aryanb1032/autonomous-sorting-robot-arm/hardware/stl/README.md

# Arm STL files

Source: the project owner's `arm stl` folder. The STL files are copied without geometry changes. Keep the original filenames so exported part names remain recognizable.

| File | Size |
|---|---:|
| `Arm 01.1.STL` | 205,784 bytes |
| `Arm 02.1.STL` | 133,684 bytes |
| `Base of Robotic Arm.STL` | 149,384 bytes |
| `Gripper cam.stl` | 302,584 bytes |
| `Rack.stl` | 168,884 bytes |
| `base J1.STL` | 282,584 bytes |
| `bearing.STL` | 57,284 bytes |
| `bearingball.STL` | 292,684 bytes |
| `g frame 1.STL` | 87,584 bytes |
| `gripper connector.STL` | 247,884 bytes |
| `gripper finger.stl` | 93,484 bytes |
| `link 3.2.STL` | 105,084 bytes |

STL files do not reliably carry print units. Confirm scale in the slicer/CAD software before printing.
