aryanb1032/autonomous-sorting-robot-arm/hardware/stl/Gripper cam.stl

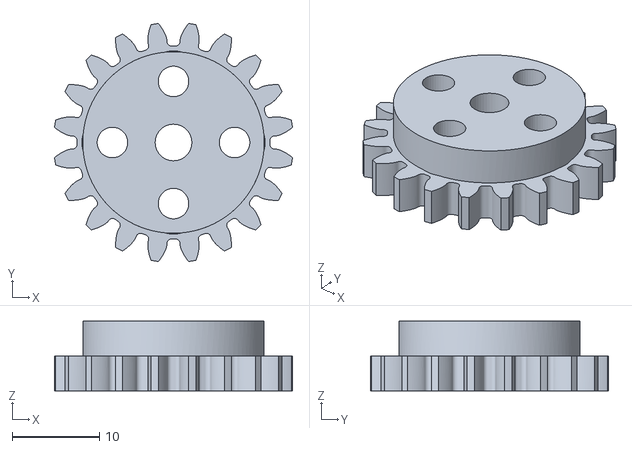
[picture p1: CAD file, 2026-11-10]
hardware/stl/Gripper cam.stl
27.3 x 27.3 x 8.00
