aryanb1032/autonomous-sorting-robot-arm/hardware/stl/bearingball.STL

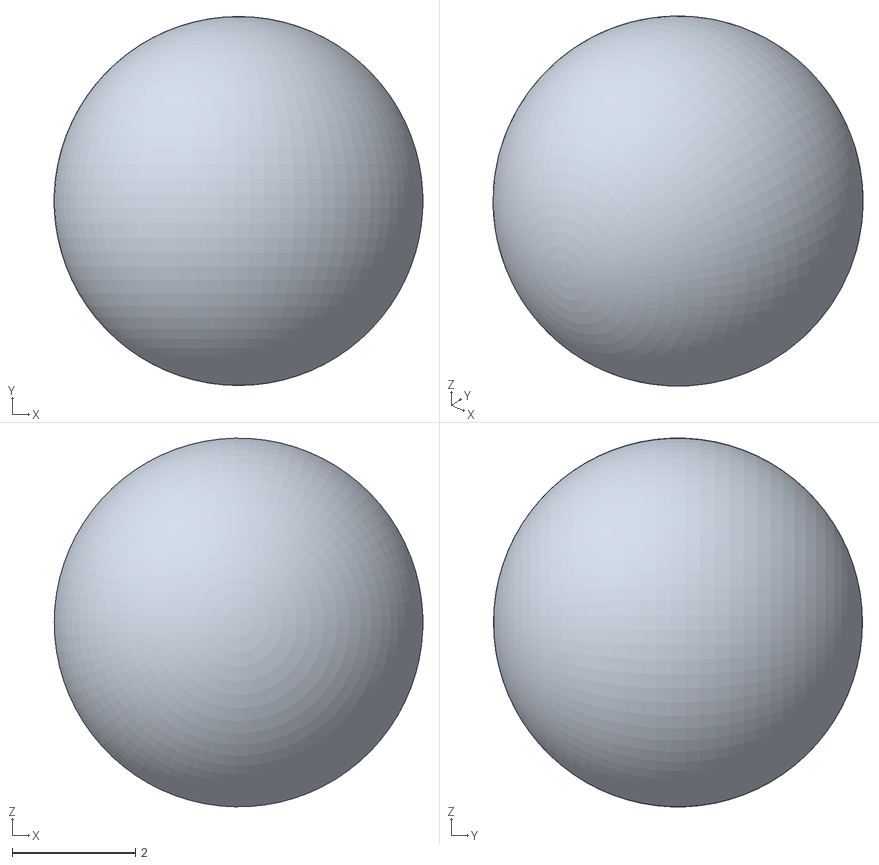
[picture p2: CAD file, 2026-11-10]
hardware/stl/bearingball.STL
5.99 x 6.00 x 5.99
