aryanb1032/autonomous-sorting-robot-arm/hardware/stl/g frame 1.STL

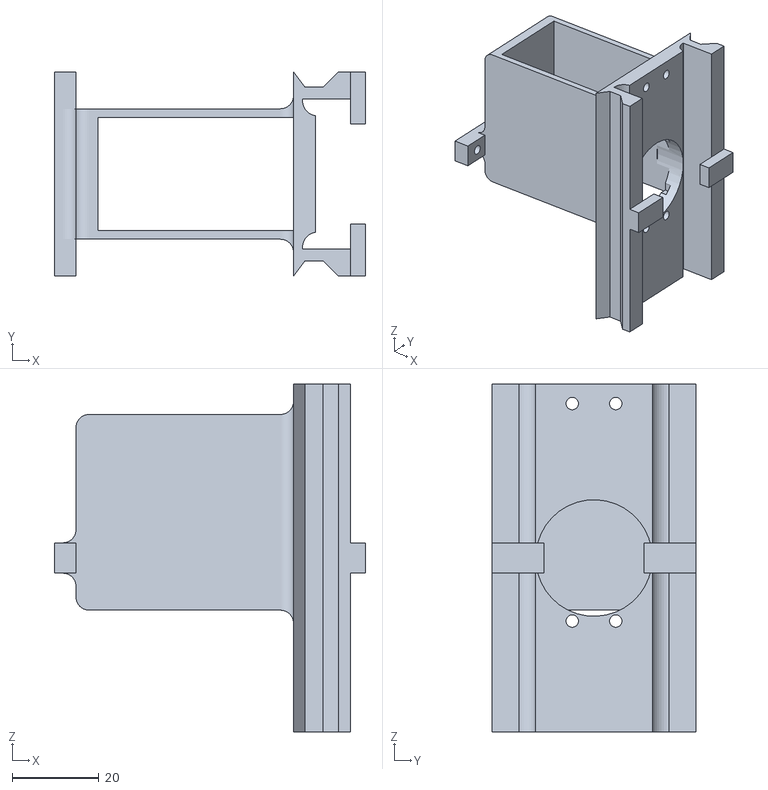
[picture p3: CAD file, 2026-11-10]
hardware/stl/g frame 1.STL
71.6 x 47.0 x 80.0
