aryanb1032/autonomous-sorting-robot-arm/hardware/stl/link 3.2.STL

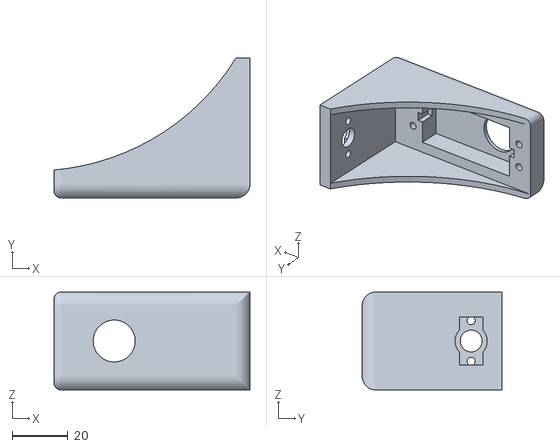
[picture p4: CAD file, 2026-11-10]
hardware/stl/link 3.2.STL
70.0 x 50.0 x 35.0
