aryanb1032/autonomous-sorting-robot-arm/hardware/stl/gripper finger.stl

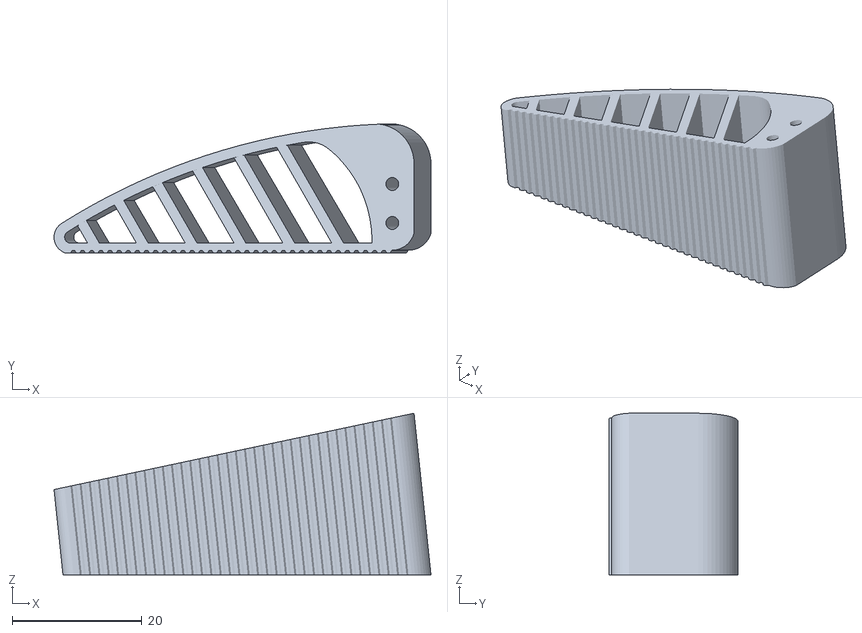
[picture p5: CAD file, 2026-11-10]
hardware/stl/gripper finger.stl
58.0 x 19.8 x 24.9
