aryanb1032/autonomous-sorting-robot-arm/hardware/stl/Rack.stl

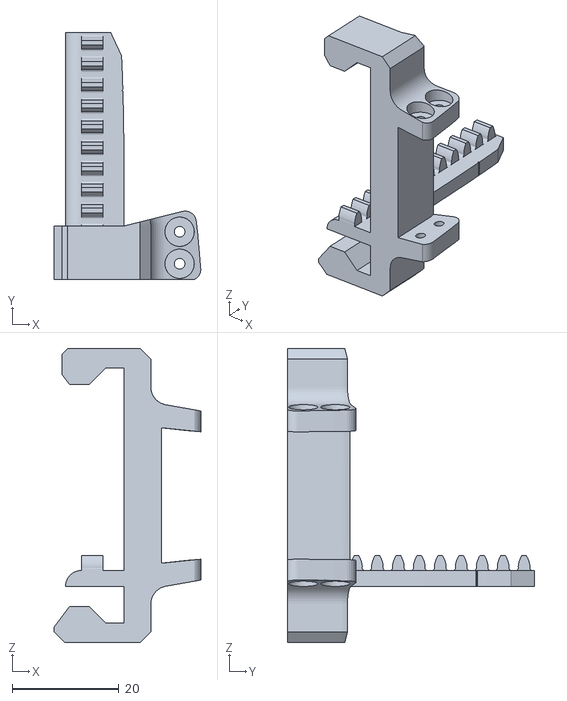
[picture p6: CAD file, 2026-11-10]
hardware/stl/Rack.stl
27.5 x 46.2 x 55.1
