aryanb1032/autonomous-sorting-robot-arm/hardware/stl/Base of Robotic Arm.STL

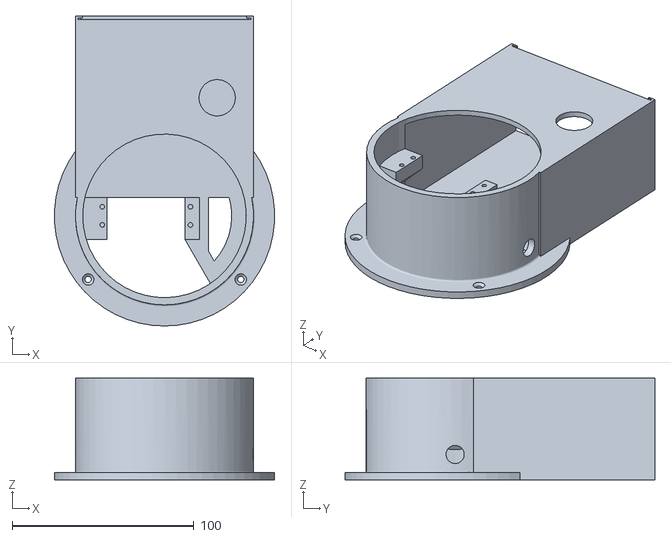
[picture p7: CAD file, 2026-11-10]
hardware/stl/Base of Robotic Arm.STL
121.1 x 170.6 x 56.0
