aryanb1032/autonomous-sorting-robot-arm/hardware/stl/Arm 01.1.STL

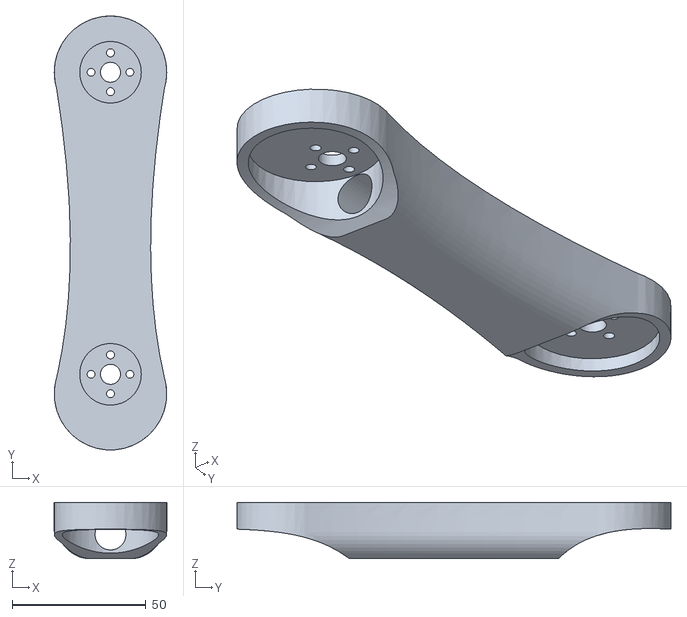
[picture p8: CAD file, 2026-11-10]
hardware/stl/Arm 01.1.STL
42.0 x 162.0 x 21.0
