aryanb1032/autonomous-sorting-robot-arm/hardware/stl/gripper connector.STL

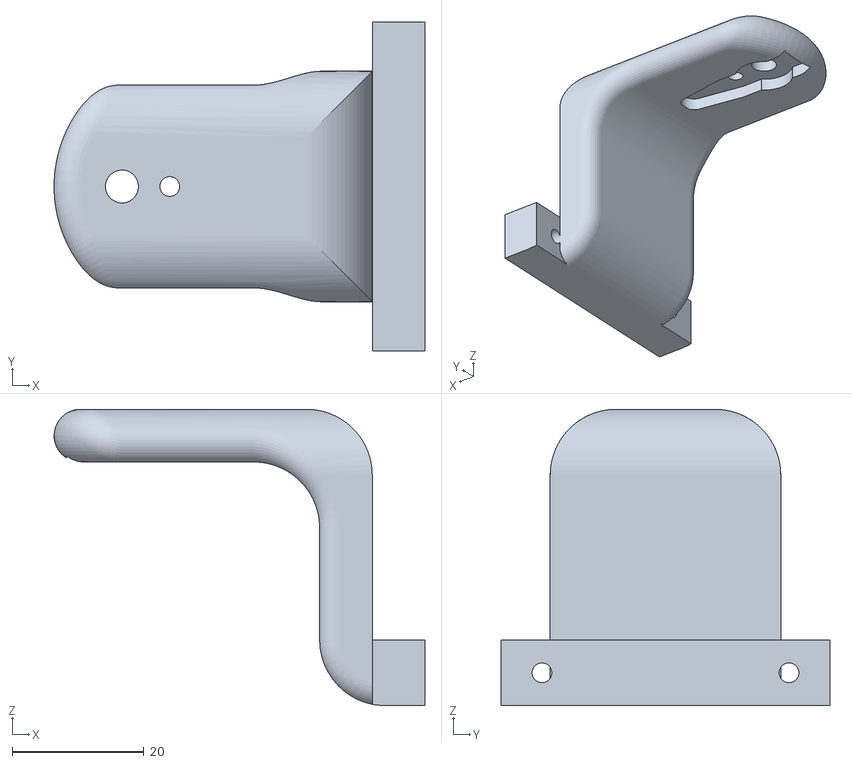
[picture p9: CAD file, 2026-11-10]
hardware/stl/gripper connector.STL
56.3 x 50.0 x 45.0
