aryanb1032/autonomous-sorting-robot-arm/hardware/stl/base J1.STL

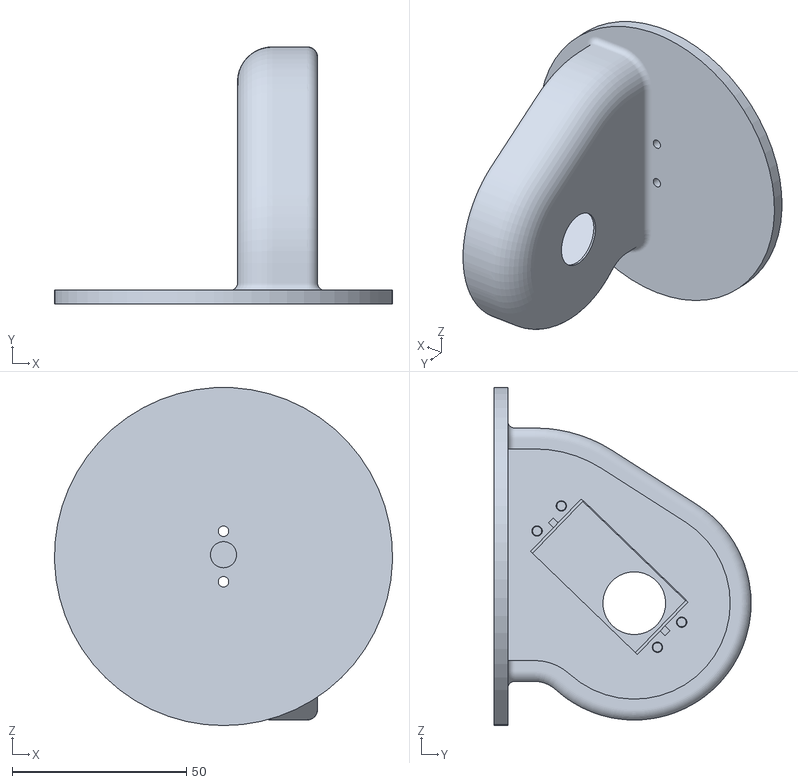
[picture p10: CAD file, 2026-11-10]
hardware/stl/base J1.STL
97.0 x 73.8 x 97.0
