aryanb1032/autonomous-sorting-robot-arm/hardware/stl/Arm 02.1.STL

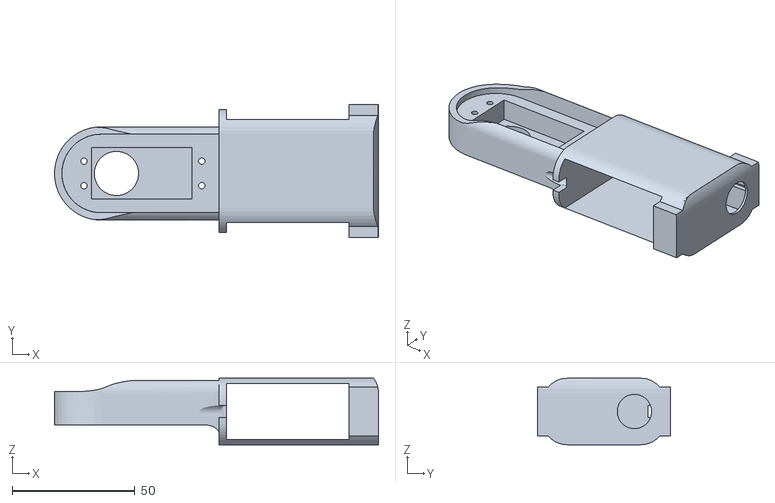
[picture p11: CAD file, 2026-11-10]
hardware/stl/Arm 02.1.STL
132.0 x 54.0 x 27.1
