aryanb1032/autonomous-sorting-robot-arm/hardware/stl/bearing.STL

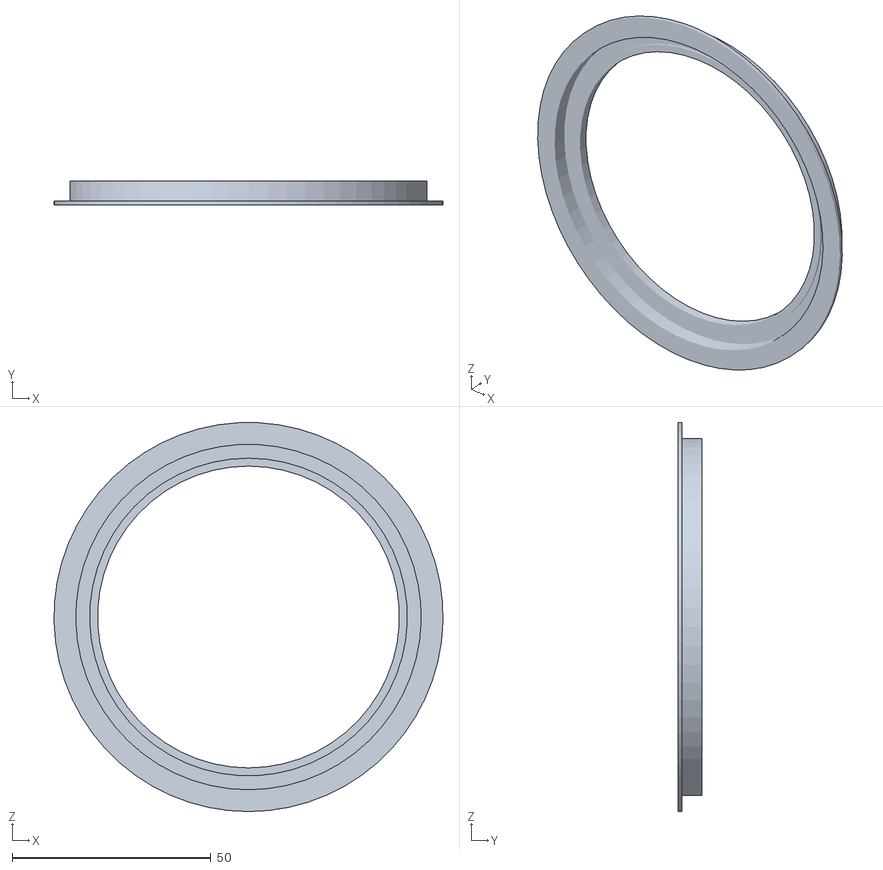
[picture p12: CAD file, 2026-11-10]
hardware/stl/bearing.STL
98.0 x 6.00 x 98.0
