aryanb1032/autonomous-sorting-robot-arm/ros2_ws/src/arm_simulation/urdf/provisional_arm.urdf

<?xml version="1.0" ?>
<!-- =================================================================================== -->
<!-- |    This document was autogenerated by xacro from ros2_ws/src/arm_simulation/urdf/provisional_arm.urdf.xacro | -->
<!-- |    EDITING THIS FILE BY HAND IS NOT RECOMMENDED                                 | -->
<!-- =================================================================================== -->
<!-- Final user axis distances, 2026-10-29. Collision/visual shapes and masses are
approximations. The pictured linkage is represented by two mirrored hinged jaws;
its exact four-bar dimensions and servo linkage remain unmeasured. -->
<robot name="provisional_arm">
  <link name="world"/>
  <link name="base_link">
    <inertial>
      <origin xyz="0 0 0.0175"/>
      <mass value="1.0"/>
      <inertia ixx="0.0013020833333333333" ixy="0" ixz="0" iyy="0.0013020833333333333" iyz="0" izz="0.0024"/>
    </inertial>
    <visual>
      <origin xyz="0 0 0.0175"/>
      <geometry>
        <box size="0.12 0.12 0.035"/>
      </geometry>
      <material name="base_link_colour">
        <color rgba=".12 .14 .18 1"/>
      </material>
    </visual>
    <collision>
      <origin xyz="0 0 0.0175"/>
      <geometry>
        <box size="0.12 0.12 0.035"/>
      </geometry>
    </collision>
  </link>
  <joint name="world_fixed" type="fixed">
    <parent link="world"/>
    <child link="base_link"/>
    <origin xyz="0 0 0"/>
  </joint>
  <link name="base_rotor">
    <inertial>
      <origin xyz="0 0 0.0095"/>
      <mass value="0.2"/>
      <inertia ixx="6.601666666666667e-05" ixy="0" ixz="0" iyy="6.601666666666667e-05" iyz="0" izz="0.00012"/>
    </inertial>
    <visual>
      <origin xyz="0 0 0.0095"/>
      <geometry>
        <box size="0.06 0.06 0.019"/>
      </geometry>
      <material name="base_rotor_colour">
        <color rgba=".15 .4 .75 1"/>
      </material>
    </visual>
    <collision>
      <origin xyz="0 0 0.0095"/>
      <geometry>
        <box size="0.06 0.06 0.019"/>
      </geometry>
    </collision>
  </link>
  <joint name="sim_joint_1" type="revolute">
    <parent link="base_link"/>
    <child link="base_rotor"/>
    <origin xyz="0 0 0.035"/>
    <axis xyz="0 0 1"/>
    <limit effort="20" lower="-2.8" upper="2.8" velocity="0.6"/>
    <dynamics damping="0.1" friction="0.01"/>
  </joint>
  <link name="upper_arm">
    <inertial>
      <origin xyz="0 0 0.06"/>
      <mass value="0.3"/>
      <inertia ixx="0.00039062499999999997" ixy="0" ixz="0" iyy="0.00039062499999999997" iyz="0" izz="6.125000000000001e-05"/>
    </inertial>
    <visual>
      <origin xyz="0 0 0.06"/>
      <geometry>
        <box size="0.035 0.035 0.12"/>
      </geometry>
      <material name="upper_arm_colour">
        <color rgba=".15 .4 .75 1"/>
      </material>
    </visual>
    <collision>
      <origin xyz="0 0 0.06"/>
      <geometry>
        <box size="0.035 0.035 0.12"/>
      </geometry>
    </collision>
  </link>
  <joint name="sim_joint_2" type="revolute">
    <parent link="base_rotor"/>
    <child link="upper_arm"/>
    <origin xyz="0 0 0.019"/>
    <axis xyz="0 1 0"/>
    <limit effort="20" lower="-1.4" upper="1.4" velocity="0.6"/>
    <dynamics damping="0.1" friction="0.01"/>
  </joint>
  <link name="forearm">
    <inertial>
      <origin xyz="0 0 0.055"/>
      <mass value="0.25"/>
      <inertia ixx="0.0002708333333333333" ixy="0" ixz="0" iyy="0.0002708333333333333" iyz="0" izz="3.75e-05"/>
    </inertial>
    <visual>
      <origin xyz="0 0 0.055"/>
      <geometry>
        <box size="0.03 0.03 0.11"/>
      </geometry>
      <material name="forearm_colour">
        <color rgba=".15 .4 .75 1"/>
      </material>
    </visual>
    <collision>
      <origin xyz="0 0 0.055"/>
      <geometry>
        <box size="0.03 0.03 0.11"/>
      </geometry>
    </collision>
  </link>
  <joint name="sim_joint_3" type="revolute">
    <parent link="upper_arm"/>
    <child link="forearm"/>
    <origin xyz="0 0 0.12"/>
    <axis xyz="0 1 0"/>
    <limit effort="20" lower="-2.0" upper="2.0" velocity="0.6"/>
    <dynamics damping="0.1" friction="0.01"/>
  </joint>
  <link name="wrist_pitch">
    <inertial>
      <origin xyz="0 0 0.03"/>
      <mass value="0.08"/>
      <inertia ixx="3.4666666666666665e-05" ixy="0" ixz="0" iyy="3.4666666666666665e-05" iyz="0" izz="2.1333333333333338e-05"/>
    </inertial>
    <visual>
      <origin xyz="0 0 0.03"/>
      <geometry>
        <box size="0.04 0.04 0.06"/>
      </geometry>
      <material name="wrist_pitch_colour">
        <color rgba=".15 .4 .75 1"/>
      </material>
    </visual>
    <collision>
      <origin xyz="0 0 0.03"/>
      <geometry>
        <box size="0.04 0.04 0.06"/>
      </geometry>
    </collision>
  </link>
  <joint name="sim_joint_4" type="revolute">
    <parent link="forearm"/>
    <child link="wrist_pitch"/>
    <origin xyz="0 0 0.11"/>
    <axis xyz="0 1 0"/>
    <limit effort="20" lower="-1.5" upper="1.5" velocity="0.6"/>
    <dynamics damping="0.1" friction="0.01"/>
  </joint>
  <link name="gripper_palm">
    <inertial>
      <origin xyz="0 0 0.05"/>
      <mass value="0.1"/>
      <inertia ixx="0.00010020833333333335" ixy="0" ixz="0" iyy="9.666666666666668e-05" iyz="0" izz="3.020833333333333e-05"/>
    </inertial>
    <visual>
      <origin xyz="0 0 0.05"/>
      <geometry>
        <box size="0.04 0.045 0.1"/>
      </geometry>
      <material name="gripper_palm_colour">
        <color rgba=".15 .4 .75 1"/>
      </material>
    </visual>
    <collision>
      <origin xyz="0 0 0.05"/>
      <geometry>
        <box size="0.04 0.045 0.1"/>
      </geometry>
    </collision>
  </link>
  <joint name="sim_joint_5" type="revolute">
    <parent link="wrist_pitch"/>
    <child link="gripper_palm"/>
    <origin xyz="0 0 0.06"/>
    <axis xyz="0 0 1"/>
    <limit effort="20" lower="-2.8" upper="2.8" velocity="0.6"/>
    <dynamics damping="0.1" friction="0.01"/>
  </joint>
  <link name="left_finger">
    <inertial>
      <origin xyz="0 0 0.035"/>
      <mass value="0.025"/>
      <inertia ixx="1.0341666666666668e-05" ixy="0" ixz="0" iyy="1.0508333333333336e-05" iyz="0" izz="4.333333333333334e-07"/>
    </inertial>
    <visual>
      <origin xyz="0 0 0.035"/>
      <geometry>
        <box size="0.012 0.008 0.07"/>
      </geometry>
      <material name="left_finger_colour">
        <color rgba=".9 .9 .85 1"/>
      </material>
    </visual>
    <collision>
      <origin xyz="0 0 0.035"/>
      <geometry>
        <box size="0.012 0.008 0.07"/>
      </geometry>
    </collision>
  </link>
  <joint name="sim_finger_joint" type="revolute">
    <parent link="gripper_palm"/>
    <child link="left_finger"/>
    <origin xyz="0 .012 0.1"/>
    <axis xyz="-1 0 0"/>
    <limit effort="20" lower="0.0" upper="0.4" velocity="0.6"/>
    <dynamics damping="0.1" friction="0.01"/>
  </joint>
  <link name="right_finger">
    <inertial>
      <origin xyz="0 0 0.035"/>
      <mass value="0.025"/>
      <inertia ixx="1.0341666666666668e-05" ixy="0" ixz="0" iyy="1.0508333333333336e-05" iyz="0" izz="4.333333333333334e-07"/>
    </inertial>
    <visual>
      <origin xyz="0 0 0.035"/>
      <geometry>
        <box size="0.012 0.008 0.07"/>
      </geometry>
      <material name="right_finger_colour">
        <color rgba=".9 .9 .85 1"/>
      </material>
    </visual>
    <collision>
      <origin xyz="0 0 0.035"/>
      <geometry>
        <box size="0.012 0.008 0.07"/>
      </geometry>
    </collision>
  </link>
  <joint name="sim_finger_mimic" type="revolute">
    <parent link="gripper_palm"/>
    <child link="right_finger"/>
    <origin xyz="0 -.012 0.1"/>
    <axis xyz="1 0 0"/>
    <limit effort="20" lower="0.0" upper="0.4" velocity="0.6"/>
    <dynamics damping="0.1" friction="0.01"/>
    <mimic joint="sim_finger_joint" multiplier="1" offset="0"/>
  </joint>
  <link name="gripper_motor_frame"/>
  <joint name="gripper_motor_fixed" type="fixed">
    <parent link="gripper_palm"/>
    <child link="gripper_motor_frame"/>
    <origin xyz="0 0 0.1"/>
  </joint>
  <link name="tool0"/>
  <joint name="tool_fixed" type="fixed">
    <parent link="gripper_palm"/>
    <child link="tool0"/>
    <origin xyz="0 0 0.17"/>
  </joint>
  <link name="camera_link">
    <inertial>
      <origin xyz="0.035 0 0"/>
      <mass value="0.015"/>
      <inertia ixx="1.0625e-06" ixy="0" ixz="0" iyy="1.0625e-06" iyz="0" izz="1.5625e-06"/>
    </inertial>
    <visual>
      <origin xyz="0.035 0 0"/>
      <geometry>
        <box size="0.025 0.025 0.015"/>
      </geometry>
      <material name="camera_link_colour">
        <color rgba=".1 .1 .1 1"/>
      </material>
    </visual>
    <collision>
      <origin xyz="0.035 0 0"/>
      <geometry>
        <box size="0.025 0.025 0.015"/>
      </geometry>
    </collision>
  </link>
  <joint name="camera_fixed" type="fixed">
    <parent link="gripper_palm"/>
    <child link="camera_link"/>
    <origin xyz="0 0 0.1"/>
  </joint>
  <ros2_control name="SimulationOnly" type="system">
    <hardware>
      <plugin>mock_components/GenericSystem</plugin>
    </hardware>
    <joint name="sim_joint_1">
      <command_interface name="position"/>
      <state_interface name="position">
        <param name="initial_value">0</param>
      </state_interface>
      <state_interface name="velocity"/>
    </joint>
    <joint name="sim_joint_2">
      <command_interface name="position"/>
      <state_interface name="position">
        <param name="initial_value">0</param>
      </state_interface>
      <state_interface name="velocity"/>
    </joint>
    <joint name="sim_joint_3">
      <command_interface name="position"/>
      <state_interface name="position">
        <param name="initial_value">0</param>
      </state_interface>
      <state_interface name="velocity"/>
    </joint>
    <joint name="sim_joint_4">
      <command_interface name="position"/>
      <state_interface name="position">
        <param name="initial_value">0</param>
      </state_interface>
      <state_interface name="velocity"/>
    </joint>
    <joint name="sim_joint_5">
      <command_interface name="position"/>
      <state_interface name="position">
        <param name="initial_value">0</param>
      </state_interface>
      <state_interface name="velocity"/>
    </joint>
    <joint name="sim_finger_joint">
      <command_interface name="position"/>
      <state_interface name="position">
        <param name="initial_value">0</param>
      </state_interface>
      <state_interface name="velocity"/>
    </joint>
    <joint name="sim_finger_mimic">
      <state_interface name="position"/>
      <state_interface name="velocity"/>
    </joint>
  </ros2_control>
</robot>
