aryanb1032/autonomous-sorting-robot-arm/hardware/motor_trial/arm_controller/hardware_config.h

#pragma once
// Servo-angle bench trial: NOT robot joint coordinates.
constexpr bool HARDWARE_CALIBRATED = true;
constexpr int SDA_PIN=21, SCL_PIN=22, OE_PIN=23;
constexpr bool OE_WIRED = true;
constexpr unsigned char PCA_ADDRESS=0x40;
constexpr int JOINT_COUNT=6;
constexpr const char* CONFIG_ID="TRIAL_146bb29b64502fbb";
constexpr int CHANNEL[JOINT_COUNT]={0,1,2,5,6,7};
constexpr float RAD_LOW[JOINT_COUNT]={1.53588974175501,1.53588974175501,1.53588974175501,1.53588974175501,1.53588974175501,1.53588974175501};
constexpr float RAD_HIGH[JOINT_COUNT]={1.6057029118347832,1.6057029118347832,1.6057029118347832,1.6057029118347832,1.6057029118347832,1.6057029118347832};
constexpr float PULSE_AT_LOW[JOINT_COUNT]={1477.7777777777778,1477.7777777777778,1477.7777777777778,1477.7777777777778,1477.7777777777778,1635.5555555555557};
constexpr float PULSE_AT_HIGH[JOINT_COUNT]={1522.2222222222222,1522.2222222222222,1522.2222222222222,1522.2222222222222,1522.2222222222222,1664.4444444444443};
constexpr float INITIAL_RAD[JOINT_COUNT]={1.5707963267948966,1.5707963267948966,1.5707963267948966,1.5707963267948966,1.5707963267948966,1.5707963267948966};
constexpr float MAX_RAD_PER_SEC[JOINT_COUNT]={0.03490658503988659,0.03490658503988659,0.03490658503988659,0.03490658503988659,0.03490658503988659,0.03490658503988659};
