aryanb1032/autonomous-sorting-robot-arm/ros2_ws/src/arm_simulation/config/joint_limits.yaml

joint_limits:
  sim_joint_1:
    has_velocity_limits: true
    max_velocity: 0.5
    has_acceleration_limits: true
    max_acceleration: 0.5
  sim_joint_2:
    has_velocity_limits: true
    max_velocity: 0.5
    has_acceleration_limits: true
    max_acceleration: 0.5
  sim_joint_3:
    has_velocity_limits: true
    max_velocity: 0.5
    has_acceleration_limits: true
    max_acceleration: 0.5
  sim_joint_4:
    has_velocity_limits: true
    max_velocity: 0.5
    has_acceleration_limits: true
    max_acceleration: 0.5
  sim_joint_5:
    has_velocity_limits: true
    max_velocity: 0.5
    has_acceleration_limits: true
    max_acceleration: 0.5
  sim_finger_joint:
    has_velocity_limits: true
    max_velocity: 0.3
    has_acceleration_limits: true
    max_acceleration: 0.3
