aryanb1032/autonomous-sorting-robot-arm/(commit log)

2026-11-08 Document autonomous robot arm project snapshot
    [black_box.sdf, controllers.yaml, gazebo_controllers.yaml, joint_limits.yaml, motor_trial.json, partitions.csv, provisional_arm.urdf, provisional_arm.urdf.xacro]
2026-11-10 Add arm and gripper STL parts
    [Arm 01.1.STL, Arm 02.1.STL, Base of Robotic Arm.STL, Gripper cam.stl, Rack.stl, base J1.STL, bearing.STL, bearingball.STL]
